loggerhead-instruments/medusa-AI/altium/Medusa-AI-ESP/Project Outputs for Medusa-AI-coral-dev/Medusa-AI-coral-dev-BOM.xlsx

Comment | Description | Designator | Footprint | LibRef | Quantity
0.1uF | Ceramic Chip Capacitor - Standard | C1, C3, C4, C5, C8, C9, C11, C13, C14, C18, C49 | 0402 | C0402 | 11
10uF |  | C2 | Tant0805 | Tant0805 | 1
1uF | Ceramic Chip Capacitor - Standard | C6, C10, C15 | 0402 | C0402 | 3
0.01uF | Ceramic Chip Capacitor - Standard | C7, C12, C16 | 0402 | C0402 | 3
1.0uF | Ceramic Chip Capacitor - Standard | C17, C19, C21, C23, C24, C25, C26, C27, C28, C47 | 0402 | C0402 | 10
100nF | Ceramic Chip Capacitor - Standard | C20, C22 | 0402 | C0402 | 2
10nF | Ceramic Chip Capacitor - Standard | C29, C30 | 0402 | C0402 | 2
1uF |  | C31 | Tant0805 | Tant0805 | 1
0402 Ferrite | Ceramic Chip Capacitor - Standard | C32, C33 | 0402 | C0402 | 2
C0603 | Ceramic Chip Capacitor - Standard, 100V 20% | C34, C37, C38, C42, C48 | 0603 | C0603 | 5
T495X227K010ATE050 | Solid Tantalum Chip Capacitor, Standard T495 Series - Low ESR, Surge Robust | C35, C50 | X | T495X | 2
2.2uF | Ceramic Chip Capacitor - Standard | C36 | 0402 | C0402 | 1
C1206 | Ceramic Chip Capacitor - Standard | C39, C44 | 1206 | C1206 | 2
T495X | Solid Tantalum Chip Capacitor, Standard T495 Series - 35V 10% | C40, C41 | X | T495X | 2
C0805 | Ceramic Chip Capacitor - Standard | C43, C46 | 0805 | C0805 | 2
C0402 | Ceramic Chip Capacitor - Standard | C45 | 0402 | C0402 | 1
PMEG3050EP* |  | D1, D3 | Diode_PMEG3050EP | Diode_PMEG3050EP | 2
26.7V Breakdown |  | D2 | SMBJ24CA | SMBJ24CA | 1
BAT46WJ | Diode Schottky 100V 250mA (DC) Surface Mount SOD-323F | D4 | SOD-323 | BAT46WJ | 1
YFF31HC2A105MT000N | 1ÂµF Feed Through Capacitor 100V 6A 5mOhm 1206 (3216 Metric), 4 PC Pad | FL1, FL2 | FIL_YFF31HC2A105MT000N | YFF31HC2A105MT000N | 2
BM04B-SRSS-TB(LF)(SN) | Connector Header Surface Mount 4 position 0.039 _1.00mm_ | J1, J2 | CONN_BM04B-SRSS-TB(LF)(SN) | BM04B-SRSS-TB(LF)(SN) | 2
6.8uH | Sumida Inductor | L1 | Inductor - duplicate | Inductor 6.8uH | 1
Inductor2016 |  | L2 | Inductor2016 | Inductor2016 | 1
10uH |  | L3 | Inductor0630CDMCD | Inductor_0630CDMCD | 1
MS223-10F | RF Shield | MP1 | MS223-10F | MS223-10F | 1
Header 20X2 | Header, 20-Pin, Dual row | P1 | HDR2X20 | Header 20X2 | 1
microSD-Molex |  | P2 | microSD_Molex_hinged | microSD_Molex_hinged | 1
Teensy3.x |  | P3 | Teensy3.x | Teensy3.x | 1
GND Tie | Header, 2-Pin | P4 | HDR1X2 | Header 2 | 1
HYDROPHONE L | Header, 3-Pin | P5 | HDR1X3 | Header 3 | 1
BAT |  | P6, P33 | HDR_2x1_2mm | HDR_2x1_2mm | 2
HYDROPHONE R | Header, 3-Pin | P7 | HDR1X3 | Header 3 | 1
Iridium | Header, 7-Pin | P8 | HDR1X7 | Header 7 | 1
GPS | Header, 9-Pin | P9 | HDR1X9 | Header 9 | 1
Jumper PPS to Audio R | Header, 2-Pin | P10 | HDR1X2 | Header 2 | 1
Header 3X2 | Header, 3-Pin, Dual row | P11 | HDR2X3 | Header 3X2 | 1
Header 2X2 | Header, 2-Pin, Dual row | P12 | HDR2X2 | Header 2X2 | 1
Header 5X2 | Header, 5-Pin, Dual row | P13 | HDR2X5 | Header 5X2 | 1
Header 4 | Header, 4-Pin | P14 | HDR1X4 | Header 4 | 1
switch | Header, 3-Pin | P15 | HDR1X3 | Header 3 | 1
UltraCap | Header, 2-Pin | P20 | HDR1X2 | Header 2 | 1
3000uF | Header, 3-Pin | P21 | HDR1X3 | Header 3 | 1
SOLAR |  | P24, P25 | HDR_2x1_2mm | HDR_2x1_2mm | 2
100k | Precision Thick Film Chip Resistor, 10 Ohm to 1M Ohm Range, 1% and 0.5% Tolerance, 0603 Size, 0.063 W | R1, R2, R3, R4 | 3-0603 | ERJ3RK | 4
4.7k | Precision Thick Film Chip Resistor, 10 Ohm to 1M Ohm Range, 1% and 0.5% Tolerance, 0603 Size, 0.063 W | R5, R15 | 3-0603 | ERJ3RK | 2
330K | Precision Thick Film Chip Resistor, 10 Ohm to 1M Ohm Range, 1% and 0.5% Tolerance, 0603 Size, 0.063 W | R6, R8, R14 | 3-0603 | ERJ3EK | 3
51K | Precision Thick Film Chip Resistor, 10 Ohm to 1M Ohm Range, 1% and 0.5% Tolerance, 0603 Size, 0.063 W | R7, R9 | 3-0603 | ERJ3EK | 2
301K | Precision Thick Film Chip Resistor, 10 Ohm to 1M Ohm Range, 1% and 0.5% Tolerance, 0603 Size, 0.063 W | R10 | 3-0603 | ERJ3EK | 1
50mOhms | Precision Thick Film Chip Resistor, 10 Ohm to 2.2M Ohm Range, 1% Tolerance, 1206 Size, 0.125 W | R11 | 8-1206 | ERJ8EN | 1
205K | Precision Thick Film Chip Resistor, 10 Ohm to 1M Ohm Range, 1% and 0.5% Tolerance, 0603 Size, 0.063 W | R12 | 3-0603 | ERJ3EK | 1
64K9 | Precision Thick Film Chip Resistor, 10 Ohm to 1M Ohm Range, 1% and 0.5% Tolerance, 0603 Size, 0.063 W | R13 | 3-0603 | ERJ3EK | 1
20k | Precision Thick Film Chip Resistor, 10 Ohm to 1M Ohm Range, 1% and 0.5% Tolerance, 0603 Size, 0.063 W | R16 | 3-0603 | ERJ3RK | 1
MAX4996ETG+ | 3 Circuit IC Switch 2:2 4Ohm 24-TQFN (4x4) | U1 | QFN40P350X350X80-25N | MAX4996ETG+ | 1
LP3985IM5-3.3 | Micropower, 150mA Low-Noise Ultra Low-Dropout CMOS Voltage Regulator | U2, U4, U5, U9, U10 | MF05A_N | LP3985IM5-3.3 | 5
SGTL5000 | SGTL5000 | U3 | QFN32 | SGTL5000 | 1
ADXL343 |  | U6 | ADXL345 | ADXL345 | 1
LIS3MDL | magnetometer | U7 | LGA-12 | LIS3MDL | 1
TLV70018DCKR | Single Output LDO, 200 mA, Fixed 1.8 V Output, 2 to 5.5 V Input, with Low IQ, 5-pin SC70 (DCK), -40 to 125 degC, Green (RoHS & no Sb/Br) | U8 | TI-DCK5_V | TLV70018DCKR | 1
SAM-M8Q |  | U11 | GPS SAM-MQ8 | GPS SAM-M8Q | 1
TPS61032 | Boost converter | U12 | TPS6103x | TPS6103x | 1
LT3652EDDPBF | Power Tracking 2A Battery Charger for Solar Power | U13 | DFN300X300X80-13N | LT3652EDDPBF | 1
M138_MODEM | Swarm M138 Modem | U14 | XCVR_M138_MODEM | M138_MODEM | 1
LD39200PU33R | Linear Voltage Regulator IC 1 Output 2A 6-DFN _3x3_ | U15 | SON95P300X300X100-7N | LD39200PU33R | 1
