loggerhead-instruments/medusa-AI/altium/Swarm-mPCIe-Breakout-Board/Assembly mPCIe_Breakout01/REVA1/BOM/mPCIe_Breakout01.xlsx

Designator | Description | MANUF1 | MANUF1 P/N | Supplier | Supplier P/N | Size | TEMP | Tolerance | Value | 1K COST | Quantity | Footprint | MANUF2 | MANUF2 P/N | Comment
LED4, LED5 | SMD mono-color Chip LED, WL-SMCW, Red | Wurth Electronics | 150060RS75000 | Digikey | 732-4978-2-ND | 0603 | 40 up to +85 °C | NA | RED |  | 2 | 0603_A |  |  | 150060RS75000
J7 | HEADER, 2 Position Wire to Board Terminal Block Horizontal with Board 0.197" (5.00mm) Through Hole | Wurth Electronics Inc. | 691213710002 | Digikey | 732-2038-ND | 5mm | -40°C ~ 105°C | n/a | Green | .68 | 1 | 691213710002 |  |  | 691213710002
J1, J6 | HEADER, 3 Position Wire to Board Terminal Block Horizontal with Board 0.197" (5.00mm) Through Hole | Wurth Electronics Inc. | 691213710003 | Digikey | 732-2039-ND | 5mm | -40°C ~ 105°C | NA | Green | .93 | 2 | 691213710003 |  |  | 691213710003
PAD1, PAD2, PAD3, PAD4 | BUMPER CYLI .375" DIA X .19" BLK |  |  |  |  |  |  |  |  |  | 4 | Bumper |  |  | BS35BL05X10RP
C21 | 4.7 µF ±10% 10V Ceramic Capacitor X7R 0805 (2012 Metric) | Murata | GRM21BR71A475KA73L | Digi-Key | 490-6480-2-ND | 0805 | -55°C ~ 125°C | 10% | 4.7 µF |  | 1 | CAPC2013X135X45LL10T25 |  |  | GRM21BR71A475KA73L
U1 | Dual EIA-232 Driver / Receiver, -40 to 85 degC, 16-Pin SOIC (D), Green (RoHS & no Sb/Br) | Texas Instruments | MAX232IDR | Digi-Key | 296-26141-2-ND | 16SOIC | -40°C ~ 85°C | NA | NA |  | 1 | D0016A_M |  |  | MAX232IDR
L1 | CMC 2A 2LN 1.1 KOHM SMD | Murata Electronics | DLW5ATN112MQ2L | Digikey | 490-12641-2-ND | SMT | -40°C ~ 105°C | NA | 2A | 0.68 | 1 | FIL_DLW5ATN112MQ2L |  |  | DLW5ATN112MQ2L
FL1 | Feed Through Capacitor 100V 5mOhm 1206 (3216 Metric), 4 PC Pad | TDK Corporation | YFF31HC2A105MT000N | Digikey | 445-16151-2-ND | 1206 | -55°C ~ 125°C | 10% | 1uF | 0.19 | 1 | FIL_YFF31HC2A104MT000N_YFF31HC2A104MT000N |  |  | YFF31HC2A105MT000N
F1 | PTC RESET FUSE 24V 2A 2920 | Bel | 0ZCF0200AF2C | Digikey | 507-1749-2-ND | 2920 | -40°C ~ 85°C | NA | 2A |  | 1 | FP-0ZCF0200AF2C-MFG |  |  | 0ZCF0200AF2C
FB1 | Chip Ferrite Bead, 0805, 600Ω @ 100MHz, 0.06Ω, 25%, 2.3A | Murata | BLM21SP601SH1D | Digi-Key | 490-18588-2-ND | 0805 | -55°C ~ 125°C | NA | 600 Ohms @ 100 MHz |  | 1 | FP-BLM21-0_2-t0_85-e0_5-d-IPC_A |  |  | BLM21SP601SH1D
C6, C7, C13, C14, C15, C16 | Cap Ceramic 100nF 50V X7R 10% Pad SMD 0603 +125°C Automotive T/R | TDK | CGA3E2X7R1H104K080AA | Digi-Key | 1276-1033-2-ND | 0603 | -55°C ~ 125°C | 10% | 100nF |  | 6 | FP-CL10-0_1-MFG |  |  | CGA3E2X7R1H104K080AA
C1, C2, C3, C4, C5 | CL21 Series 0805 1uF 50V ±10% Tolerance X7R Multilayer Ceramic Chip Capacitor | Samsung | CL21B105KBFNNNG | Digi-Key | 1276-6470-2-ND | 0805 | -55°C ~ 125°C | 10% | 1 µF |  | 5 | FP-CL21-IPC_C |  |  | CL21B105KBFNNNG
C11 | Chip Multilayer Ceramic Capacitors for General Purpose, 0805, 10uF, X5R, 15%, 10%, 25V | Murata | GRM21BR61E106KA73L | Digi-Key | 490-5523-2-ND | 0805 | -55°C ~ 85°C | 10% | 10 µF |  | 1 | FP-GRM21B-0_15-IPC_C |  |  | GRM21BR61E106KA73L
C19 | Chip Multilayer Ceramic Capacitors for General Purpose, 1206, 4.7uF, X7R, 15%, 10%, 50V | TDK | C3216X5R1H475K | Digi-Key | C3216X5R1H475K | 1206 | 445-5994-2-ND | 10% | 4.7 µF |  | 1 | FP-GRM31C-0_2-e0_3_0_8-IPC_C |  |  | GRM31CR71H475KA12L
C8, C9 | Chip Multilayer Ceramic Capacitors for General Purpose, 1210, 100uF, X5R, 15%, 20%, 10V | Murata | GRM32ER61A107ME20L | Digi-Key | 490-9969-2-ND | 1210 | -55°C ~ 85°C | 20% | 100 µF |  | 2 | FP-GRM32E-0_3-0_2-IPC_B |  |  | GRM32ER61A107ME20L
C17, C18, C20 | Chip Multilayer Ceramic Capacitors for General Purpose, 0805, 10000pF, C0G, 30ppm/°C, 5%, 50V | Murata | GRM2195C1H103JA01D | Digi-Key | 490-1642-2-ND | 0805 | -55°C ~ 125°C | 5% | 10000 pF |  | 3 | FP-GRM219-0_1-IPC_B |  |  | GRM2195C1H103JA01D
U2 | IC TRNSLTR BIDIRECTIONAL 14TSSOP | Texas Instruments | LSF0204DPWR | Digi-Key | 296-40400-2-ND |  | -40°C ~ 125°C | NA | NA |  | 1 | FP-PW0014A-IPC_B |  |  | LSF0204DPWR
J9, J10, J11, J12, J13, J14, J15 | CONN JUMPER SHORTING .100" GOLD | Sullins | QPC02SXGN-RC | Digi-Key | S9337-ND | 2.54MM | -40°C ~ 85°C | NA | 3A |  | 7 | FP-QPC02SXGN-RC-MFG |  |  | QPC02SXGN-RC
D3 | TVS DIODE 15V 24.4V SMA | Diodes | SMAJ15A-13-F | Digikey | SMAJ15A-FDITR-ND | SMA | -50°C ~ 150°C | NA | NA |  | 1 | FP-SMA-MFG |  |  | SMAJ15A-13-F
J2, J4 | CONN U.FL RCPT STR 50 OHM SMD | Hirose | U.FL-R-SMT(10) | Digikey | H9161TR-ND | SMT | -40°C ~ 90°C | NA | NA |  | 2 | FP-U_FL-R-SMT_10-MFG |  |  | U.FL-R-SMT(10)
J8 | CONN RCPT USB2.0 TYPEC 5A | Global Connector Technology | USB4105-GF-A | Digikey | 2073-USB4105-GF-ATR-ND | SMT/TH | -40°C ~ 85°C | NA | NA |  | 1 | FP-USB4105-GF-A-MFG |  |  | USB4105-GF-A
D1 | Zener Voltage Regulator, 225 mW, 3-Pin SOT-23, Pb-Free, Tape and Reel | ON Semiconductor | BZX84B5V1LT1G | Digi-Key | BZX84B5V1LT1GOSTR-ND | SOT-23 | -65°C ~ 150°C | NA | 225 mW |  | 1 | ONSC-SOT-23-3-318-08_V |  |  | BZX84B5V1LT1G
U5 | USB Bridge, USB to UART USB 2.0 UART Interface 28-QFN (5x5) | Silicon Labs | CP2102N-A02-GQFN28 | Digi-Key | 336-5890-2-ND | QFN-28 | -40°C ~ 85°C | N/A | N/A | 1.22 | 1 | QFN50P500X500X100_HS-29N |  |  | CP2102N-A02-GQFN28
R19 | RES SMD 25.5KOHM 0.1% 1/10W 0603 | Susumu | RG1608P-2552-B-T5 | Digi-Key | RG16P25.5KBTR-ND | 0603 | -55°C ~ 125°C | 0.1% | 25.5 kOhms |  | 1 | RESC1608X50X30LL20T20 |  |  | RG1608P-2552-B-T5
R2, R3 | RES SMD 1.2K OHM 5% 1/10W 0603 | Bourns | CR0603-JW-122ELF | Digikey | 118-CR0603-JW-122ELFTR-ND | 0603 | -55°C ~ 155°C | ±5% | 1K2 |  | 2 | RESC1608X55X30LL15T15 |  |  | ERJ-3GEYJ122V
R7, R11, R12, R14, R17, R20 | RES SMD 1K OHM 0.1% 1/10W 0603, RES SMD 7.5K OHM 0.1% 1/10W 0603 | Panasonic | ERA-3AEB102V, ERA-3AEB752V | Digi-Key | P1.0KDBTR-ND, P7.5KDBTR-ND | 0603 | -55°C ~ 155°C | ±0.1% | 1K, 7K5 |  | 6 | RESC1608X55X30LL20T20 |  |  | ERA3AEB102V
R4, R5, R6, R9, R13, R15 | RES SMD 2.2K OHM 5% 1/10W 0603 | Vishay | CRCW06032K20JNEA | Digi-Key | 541-2.2KGTR-ND | 0603 | -55°C ~ 155°C | ±5% | 2k2 |  | 6 | RESC1609X50X30LL10T20 |  |  | CRCW06032K20JNEA
R16, R18 | RES SMD 5.1K OHM 1% 1/8W 0805 | Panasonic | ERJ-6ENF5101V | Digi-Key | P5.10KCTR-ND | 0603 | -55°C ~ 155°C | ±1% | 5K1 |  | 2 | RESC2013X70X40LL20T20 |  |  | ERJ6ENF5101V
U3 | SWARM M138 MODEM mPCIe 2.005" (50.925mm) x 1.18" (30mm) Two part connector | JAE | A: MM60-52B1-B1-R850 B: MM60-EZH039-B5-R850 | Digikey | A: 670-2274-2-ND B: 670-2276-2-ND | mPCIe | -40°C ~ 85°C | NA | NA |  | 1 | RF_VHF_JAE_MM60-52B1-B1-R850_MM60-EZH039-B5-R850_w_2005_mPCIe_card |  |  | A: MM60-52B1-B1-R850 B: MM60-EZH039-B5-R850
U4 | USB ESD PROTECTION | STMicroelectronics | USBLC6-4SC6 | Digi-Key | 497-4492-2-ND | SOT-23-6 | -40°C ~ 125°C | N/A | N/A | 0.17903 | 1 | SM/SOT23-6PIN |  |  | USBLC6-4SC6
J16, J17, J18, J19, J20, J22, J23 | Male Header, Pitch 2.54 mm, 1 x 2 Position, Height 8.38 mm, Tail Length 2.54 mm, -55 to 125 degC, RoHS, Bulk | Samtec | TSW-102-07-S-S | Digi-Key | SAM1033-02-ND | TH | -55°C ~ 125°C | NA | NA |  | 7 | SMTC-TSW-102-07-S-S |  |  | TSW-102-07-S-S
J21 | 0.025" SQ Post Header, Through-hole, Vertical, -55 to 125 degC, 2.54 mm Pitch, 3-Pin, Male, RoHS | Samtec | TSW-103-07-L-S | Digi-Key | SAM1031-03-ND | TH | -55°C ~ 125°C | NA | NA |  | 1 | SMTC-TSW-103-07-X-S |  |  | TSW-103-07-L-S
FTDI | 0.025" SQ Post Header, Through-hole, Vertical, -55 to 125 degC, 2.54 mm Pitch, 6-Pin, Male, RoHS | Samtec | TSW-106-07-F-S | Digi-Key | SAM10852-ND | TH | -55°C ~ 125°C | NA | NA |  | 1 | SMTC-TSW-106-07-X-S |  |  | TSW-106-07-F-S
D2, D4 | DIODE SCHOTTKY 30V 5A SOD128 | NXP Semiconductors | PMEG3050EP,115 | Digikey | 1727-5317-1-ND | SOD-128 | -55°C ~ 175°C | NA | 5A | .28 | 2 | SODFL620X110-2N |  |  | PMEG3050EP,115
J3, J5 | Rf Coax Conn, Sma Jack, 50 Ohm, Pcb Rohs Compliant: Yes |  |  | Digikey | 17-5-1814832-2CT-ND |  | -65°C ~ 165°C |  |  |  | 2 | TECO-5-1814832-1_V |  |  | CMP-2000-05705-2
U6 | 2A Standard Variable Output LDO Regulator | Rohm | BD00D0AWHFP-TR | Digi-Key | BD00D0AWHFPTR-ND | HRP-5 | -40°C ~ 105°C | NA | 0.55V @ 1A |  | 1 | TO172P1054X2005-6N |  |  | BD00D0AWHFP-TR
LED1, LED3 | WL-SMCW SMD Chip LED Top View Monocolor Waterclear, 30 mA, 2 V, -40 to 85 degC, 2-Pin SMD, RoHS, Tape and Reel GRN | Wurth Electronics | 150060VS75000 | Digi-Key | 732-4980-2-ND | 0603 | 40 up to +85 °C | NA | GRN |  | 2 | WE-150060VS75000_V |  |  | 150060VS75000
