loggerhead-instruments/medusa-AI/altium/Antenna/Swarm-Medusa-Antenna/Swarm-Medusa-Antenna.step

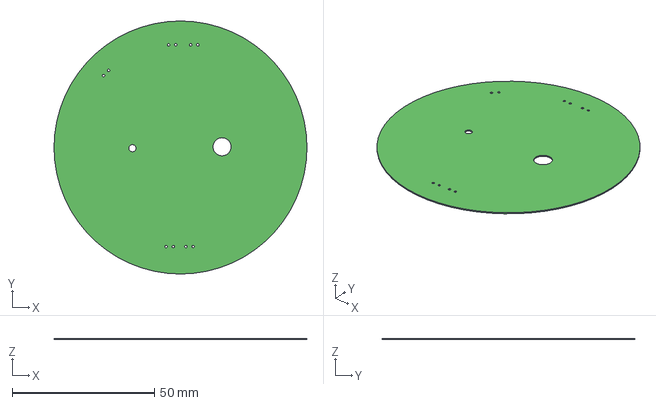
[picture p10: CAD file, 2021-11-11]
altium/Antenna/Swarm-Medusa-Antenna/Swarm-Medusa-Antenna.step
88.9 x 88.9 x 0.411 mm
