loggerhead-instruments/medusa-AI/altium/Medusa-AI-ESP/ZX-0808K-01.STEP

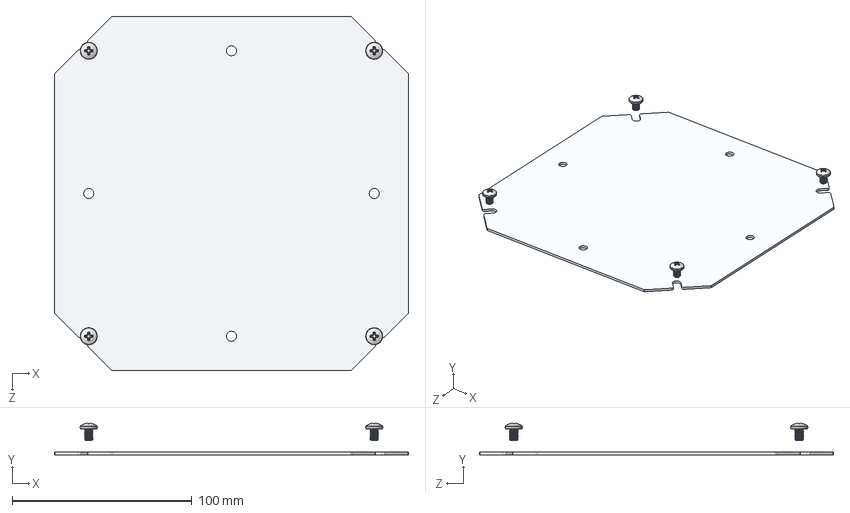
[picture p11: CAD file, 2022-02-02]
altium/Medusa-AI-ESP/ZX-0808K-01.STEP
196.9 x 17.6 x 196.8 mm
ZX-0808P-01
SCREWS-011_SCREWS-011 x 4
