loggerhead-instruments/medusa-AI/altium/medusa-AI.step

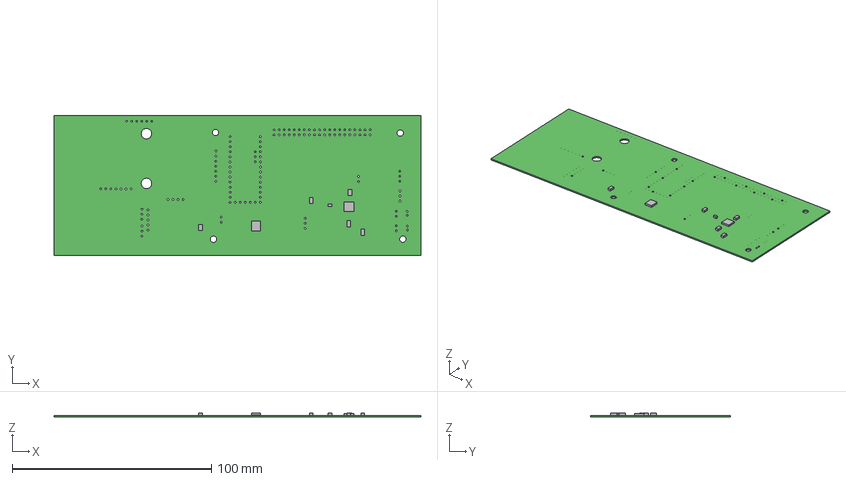
[picture p12: CAD file, 2021-11-11]
altium/medusa-AI.step
184.4 x 70.2 x 2.00 mm
Extruded x 8
