loggerhead-instruments/medusa-AI/solarTests/SunnyBuddyTestWithLS1_4LiPo.CSV

filename | ID | gain (dB) | Voltage | Version
20201031T094200.wav | 04233229012120210 | 6.56 | 3.74 | 2019-04-12
20201031T094330.wav | 04233229012120210 | 6.56 | 3.78 | 2019-04-12
20201031T094500.wav | 04233229012120210 | 6.56 | 3.78 | 2019-04-12
20201031T094630.wav | 04233229012120210 | 6.56 | 3.79 | 2019-04-12
20201031T094800.wav | 04233229012120210 | 6.56 | 3.81 | 2019-04-12
20201031T094930.wav | 04233229012120210 | 6.56 | 3.80 | 2019-04-12
20201031T095100.wav | 04233229012120210 | 6.56 | 3.79 | 2019-04-12
20201031T095230.wav | 04233229012120210 | 6.56 | 3.81 | 2019-04-12
20201031T095400.wav | 04233229012120210 | 6.56 | 3.73 | 2019-04-12
20201031T095530.wav | 04233229012120210 | 6.56 | 3.76 | 2019-04-12
20201031T095700.wav | 04233229012120210 | 6.56 | 3.84 | 2019-04-12
20201031T095830.wav | 04233229012120210 | 6.56 | 3.80 | 2019-04-12
20201031T100000.wav | 04233229012120210 | 6.56 | 3.83 | 2019-04-12
20201031T100130.wav | 04233229012120210 | 6.56 | 3.76 | 2019-04-12
20201031T100300.wav | 04233229012120210 | 6.56 | 3.81 | 2019-04-12
20201031T100430.wav | 04233229012120210 | 6.56 | 3.74 | 2019-04-12
20201031T100600.wav | 04233229012120210 | 6.56 | 3.78 | 2019-04-12
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
