loggerhead-instruments/medusa-AI/(list of files, drawings)

Other design files:
altium/Antenna/Swarm-Medusa-Antenna/Swarm-Medusa-Antenna.PcbDoc
altium/Antenna/Swarm-Medusa-Antenna/Swarm-Medusa-Antenna.PrjPcb
altium/Antenna/Swarm-Medusa-Antenna/Swarm-Medusa-Antenna.SchDoc
altium/ESP-audio-breakout/ESP-audio-breakout.PcbDoc
altium/ESP-audio-breakout/ESP-audio-breakout.PrjPcb
altium/ESP-audio-breakout/ESP-audio-breakout.SchDoc
altium/ESP-audio-breakout/medusa-ai-audio.SchDoc
altium/ESP-PCM1822Q1-breakout/ESP-PCM1822Q1-breakout.PcbDoc
altium/ESP-PCM1822Q1-breakout/ESP-PCM1822Q1-breakout.PrjPcb
altium/ESP-PCM1822Q1-breakout/ESP-PCM1822Q1-breakout.SchDoc
altium/ESP-PCM1822Q1-breakout/medusa-ai-audio.SchDoc
altium/medusa-AI-audio.SchDoc
altium/Medusa-AI-battery/Medusa-AI-battery.PcbDoc
altium/Medusa-AI-battery/Medusa-AI-battery.PrjPcb
altium/Medusa-AI-battery/Medusa-AI-battery.SchDoc
altium/Medusa-AI-coral-dev/Medusa-AI-coral-dev.PcbDoc
altium/Medusa-AI-coral-dev/Medusa-AI-coral-dev.PrjPcb
altium/Medusa-AI-coral-dev/Medusa-AI-coral-dev.SchDoc
altium/Medusa-AI-ESP/medusa-ai-audio.SchDoc
altium/Medusa-AI-ESP/Medusa-AI-ESP.PcbDoc
altium/Medusa-AI-ESP/Medusa-AI-ESP.PrjPcb
altium/Medusa-AI-ESP/Medusa-AI-ESP.SchDoc
altium/Medusa-AI-ESP/medusa-ai-power.SchDoc
altium/Medusa-AI-ESP/medusa-ai-sensors.SchDoc
altium/Medusa-AI-ESP/medusa-charger.SchDoc
altium/Medusa-AI-integrated-charger/Medusa-AI-integrated-charger.PrjPcb
altium/Medusa-AI-integrated-charger/medusa-ai-integrated-charger.SchDoc
altium/Medusa-AI-integrated-charger/medusa-ai-integrated.PcbDoc
altium/medusa-AI-power.SchDoc
altium/medusa-AI-sensors.SchDoc
altium/medusa-AI.PcbDoc
altium/medusa-AI.PrjPCB
altium/medusa-AI.SchDoc
altium/medusaCharger/medusaCharger.PcbDoc
altium/medusaCharger/medusaCharger.PrjPcb
altium/medusaCharger/medusaCharger.SchDoc
altium/microSDAdaptor/microSDAdaptor.PcbDoc
altium/microSDAdaptor/microSDAdaptor.PrjPcb
altium/microSDAdaptor/microSDAdaptor.SchDoc
altium/PCB_Project/PCB_Project.PrjPcb
altium/Swarm-M138-Modem-Altium-Footprint/Altium Footprint/SWARM_M138.PcbLib
altium/Swarm-M138-Modem-Altium-Footprint/Altium Footprint/SWARM_M138.SCHLIB
altium/Swarm-mPCIe-Breakout-Board/Sources/mPCIe_Breakout01.PrjPCB
altium/Swarm-mPCIe-Breakout-Board/Sources/PCB/mPCIe_Breakout01_2X2_PNL.PcbDoc
altium/Swarm-mPCIe-Breakout-Board/Sources/SCH/mPCIe_Breakout01-SCH-PAGE2_MAIN.SchDoc
altium/Swarm-mPCIe-Breakout-Board/Sources/SCH/mPCIe_Breakout01_SCH-PAGE1_TITLE.SchDoc
altium/Swarm-mPCIe-Breakout-Board/Sources/SCH/mPCIe_Breakout01_SCH-PAGE3_POWER_SUPPLY.SchDoc
altium/Tile-carrier/Tile-carrier.PcbDoc
altium/Tile-carrier/Tile-carrier.PrjPcb
altium/Tile-carrier/Tile-carrier.SchDoc
devBoardMini/Medusa-AI-coral-dev.PrjPcb
