loggerhead-instruments/medusa-AI/arduino/medusa-AI/display.ino

/* DISPLAY FUNCTIONS
 *  
 */

void displayOn(){
  display.begin(SSD1306_SWITCHCAPVCC, 0x3C);  //initialize display
}

void displayOff(){
  display.ssd1306_command(SSD1306_DISPLAYOFF);
}

void cDisplay(){
  display.clearDisplay();
  display.setTextColor(WHITE);
  display.setTextSize(1);
  display.setCursor(65,0);
  #ifdef IRIDIUM_MODEM
    display.print("I:");
    display.print(sigStrength);
  #endif
  
  display.setCursor(90,0);
  display.print(voltage,1);
  display.print("V");

  #ifdef SWARM_MODEM
    display.setCursor(90,9);
    display.print(rssi);
  #endif
  
  display.setCursor(0,0);
  display.display();
}

void displaySettings(){
  display.setTextSize(1);
  display.setTextColor(WHITE);
  display.setCursor(0, 0);
  if(mode==0) {
    display.println("SBY");
    display.print(startTime - t);
    display.println("s");
  }
  display.print("Rec ");
  display.print(rec_dur);
  display.print("s");
  display.print("  Sleep ");
  display.print(rec_int);
  display.println("s");
}

void displayClock(int loc, time_t t){
  display.setTextSize(1);
  display.setCursor(0,loc);
  display.print(year(t));
  display.print('-');
  display.print(month(t));
  display.print('-');
  display.print(day(t));
  display.print("  ");
  printZero(hour(t));
  display.print(hour(t));
  printDigits(minute(t));
  printDigits(second(t));
}

void printDigits(int digits){
  // utility function for digital clock display: prints preceding colon and leading 0
  display.print(":");
  printZero(digits);
  display.print(digits);
}

void printZero(int val){
  if(val<10) display.print("0");
}


// 
//void printDigits(int digits){
//  // utility function for digital clock display: prints preceding colon and leading 0
//  display.print(":");
//  printZero(digits);
//  display.print(digits);
//}
//
//void printZero(int val){
//  if(val<10) display.print('0');
//}

void setTeensyTime(int hr, int mn, int sc, int dy, int mh, int yr){
  tmElements_t tm;
  tm.Year = yr - 1970;
  tm.Month = mh;
  tm.Day = dy;
  tm.Hour = hr;
  tm.Minute = mn;
  tm.Second = sc;
  time_t newtime;
  newtime = makeTime(tm); 
  Teensy3Clock.set(newtime); 
}
 
void printTime(time_t t){
  Serial.print(year(t));
  Serial.print('-');
  Serial.print(month(t));
  Serial.print('-');
  Serial.print(day(t));
  Serial.print(" ");
  Serial.print(hour(t));
  Serial.print(':');
  Serial.print(minute(t));
  Serial.print(':');
  Serial.println(second(t));
}

void readEEPROM(){
  rec_dur = readEEPROMlong(0);
  rec_int = readEEPROMlong(4);
}

union {
  byte b[4];
  long lval;
}u;

long readEEPROMlong(int address){
  u.b[0] = EEPROM.read(address);
  u.b[1] = EEPROM.read(address + 1);
  u.b[2] = EEPROM.read(address + 2);
  u.b[3] = EEPROM.read(address + 3);
  return u.lval;
}

void writeEEPROMlong(int address, long val){
  u.lval = val;
  EEPROM.write(address, u.b[0]);
  EEPROM.write(address + 1, u.b[1]);
  EEPROM.write(address + 2, u.b[2]);
  EEPROM.write(address + 3, u.b[3]);
}

void writeEEPROM(){
  writeEEPROMlong(0, rec_dur);  //long
  writeEEPROMlong(4, rec_int);  //long
}
