loggerhead-instruments/medusa-AI/(commit log)

2020-10-20 initial schematic
    [medusa-AI-audio.SchDoc, medusa-AI-sensors.SchDoc, medusa-AI.PrjPCB, medusa-AI.SchDoc]
2021-01-18 add iridium antenna IR
    [medusa-AI-sensors.SchDoc, medusa-AI.PcbDoc, medusa-AI.SchDoc]
2021-01-19 FInal PCB
    [medusa-AI-sensors.SchDoc, medusa-AI.PcbDoc, medusa-AI.PrjPCB, medusa-AI.SchDoc]
2021-02-11 logic for SD switch
2021-02-13 pick and place
    [Pick Place for medusa-AI.csv, Pick Place for medusa-AI.xlsx, medusa-AI.PcbDoc, medusa-AI.PrjPCB]
2021-02-13 Pi control by Teensy
2021-02-13 pi no 3v3 connection
    [medusa-AI.PcbDoc, medusa-AI.SchDoc]
2021-02-14 remove 3v3 from pi
    [medusa-AI.PcbDoc]
2021-03-03 Swarm antenna PCB
    [Swarm-Medusa-Antenna.PcbDoc, Swarm-Medusa-Antenna.PrjPcb, Swarm-Medusa-Antenna.SchDoc]
2021-03-03 rearrange Medusa PCB
    [medusa-AI-sensors.SchDoc, medusa-AI.PcbDoc, medusa-AI.SchDoc]
2021-03-03 Increase record duration for power test
2021-03-08 antenna board
2021-03-16 parse DT and GPS
    [medusa-AI.PrjPCB]
2021-03-16 println for data packet
2021-04-05 solar panels parallel ground plane
    [Swarm-Medusa-Antenna.PcbDoc, Swarm-Medusa-Antenna.SchDoc]
2021-04-05 Tile carrier PCB
    [Tile-carrier.PcbDoc, Tile-carrier.PrjPcb, Tile-carrier.SchDoc]
2021-04-05 add diodes and via stitching
    [Swarm-Medusa-Antenna.PcbDoc, Swarm-Medusa-Antenna.SchDoc]
2021-04-05 update tile carrier
    [Tile-carrier.PcbDoc]
2021-04-06 Add tile
    [medusa-AI-power.SchDoc, medusa-AI.PcbDoc, medusa-AI.PrjPCB, medusa-AI.SchDoc]
2021-04-26 update PCB
    [Pick Place for medusa-AI.csv, Swarm-Medusa-Antenna.PrjPcb]
2021-09-30 solar charger pcb
    [medusaCharger.PrjPcb, medusaCharger.SchDoc]
2021-10-12 via stitching
    [medusaCharger.PcbDoc, medusaCharger.PrjPcb]
2021-11-16 bugfix dirs, logging try/except
    [audioProcess.py]
2021-12-01 sleep if battery low & log RSSI
2021-12-01 update voltage reading prior to start
2021-12-03 revert to Iridium and external GPS
    [display.ino, medusa-AI.ino]
2021-12-09 iridium powered off battery
2021-12-09 altium update
    [medusa-AI.PrjPCB, medusa-AI.SchDoc]
2022-02-02 Medusa-AI Integrated PCB
    [Medusa-AI-integrated-charger.PrjPcb, ZX-0808K-01.STEP, medusa-ai-audio.SchDoc, medusa-ai-integrated-charger.SchDoc, medusa-ai-integrated.PcbDoc, medusa-ai-power.SchDoc, medusa-charger.SchDoc]
2022-02-02 Don't send when voltage <3.7V
2022-02-02 update project structure
    [Medusa-AI-integrated-charger.PrjPcb, medusa-ai-integrated.PcbDoc]
2022-02-02 sensors on separate schematic; add GPS
    [medusa-ai-audio.SchDoc, medusa-ai-integrated-charger.SchDoc, medusa-ai-integrated.PcbDoc, medusa-ai-sensors.SchDoc, medusa-charger.SchDoc]
2022-02-04 Battery PCB
    [Medusa-AI-battery.PcbDoc, Medusa-AI-battery.PrjPcb, Medusa-AI-battery.SchDoc]
2022-02-04 remove battery connectors
    [medusa-ai-integrated.PcbDoc, medusa-charger.SchDoc]
2022-02-09 initial integrated Medusa-AI layout
    [Medusa-AI-battery.PcbDoc, Medusa-AI-integrated-charger.PrjPcb, medusa-ai-audio.SchDoc, medusa-ai-integrated-charger.SchDoc, medusa-ai-integrated.PcbDoc, medusa-ai-power.SchDoc, medusa-charger.SchDoc]
2022-02-10 adafruit GPS footprint, fix display footprint, Pi mounting holes
    [medusa-ai-integrated-charger.SchDoc, medusa-ai-integrated.PcbDoc, medusa-ai-sensors.SchDoc]
2022-02-10 logo and contact info
    [medusa-ai-integrated.PcbDoc]
2022-02-10 second optional mounting location for Coral
    [medusa-ai-integrated.PcbDoc]
2022-02-12 rockblock Vin
    Pi and Iridium run off VCC5. When VCC5 turned on, Iridium should be put to sleep so doesn't draw power.
    [medusa-ai-integrated-charger.SchDoc, medusa-ai-integrated.PcbDoc, medusa-ai-power.SchDoc]
2022-02-14 medusa-ai battery project update
    [Medusa-AI-battery.PrjPcb]
2022-02-14 medusa-AI project update
    [Medusa-AI-integrated-charger.PrjPcb]
2022-03-09 move cap and resistors to avoid collision and being covered
    [medusa-ai-integrated.PcbDoc]
2022-03-09 Update Pick Place for medusa-ai-integrated.xlsx
    [Pick Place for medusa-ai-integrated.xlsx]
2022-04-19 coral dev board mini
    [Medusa-AI-coral-dev.PrjPcb, Medusa-AI-coral-dev.SchDoc, Pick Place for medusa-ai-integrated.csv, Pick Place for medusa-ai-integrated.xlsx, ZX-0808K-01.STEP, medusa-ai-audio.SchDoc, medusa-ai-power.SchDoc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]
2022-04-19 add swarm
    [Medusa-AI-coral-dev.SchDoc, medusa-ai-power.SchDoc, medusa-charger.SchDoc]
2022-04-20 fix Swarm RX/TX
    [Medusa-AI-coral-dev.PcbDoc, Medusa-AI-coral-dev.PrjPcb, Medusa-AI-coral-dev.SchDoc]
2022-04-20 move coral away from edge; DRC
    [Medusa-AI-coral-dev.PcbDoc, Medusa-AI-coral-dev.SchDoc]
2022-04-21 move dev board mini; add big cap to swarm
    [Medusa-AI-coral-dev.PcbDoc, medusa-ai-power.SchDoc]
2022-05-27 microSD adaptor
    [microSDAdaptor.PcbDoc, microSDAdaptor.PrjPcb, microSDAdaptor.SchDoc]
2022-06-16 update with larger solar charger chip
    [Medusa-AI-coral-dev.PcbDoc, Medusa-AI-coral-dev.SchDoc, medusa-charger.SchDoc]
2022-06-23 medusa ai update
    [Medusa-AI-coral-dev-BOM.xlsx, Medusa-AI-coral-dev.PcbDoc]
2022-07-15 move power connector header for Coral
    [Medusa-AI-coral-dev.PcbDoc]
2022-08-25 add header to wire Coral button to Teensy pin
    [Medusa-AI-coral-dev.PcbDoc, Medusa-AI-coral-dev.SchDoc, medusa-charger.SchDoc]
2022-08-26 fix solar charger circuit
    [Medusa-AI-coral-dev.PcbDoc, Medusa-AI-coral-dev.SchDoc, medusa-ai-audio.SchDoc, medusa-charger.SchDoc]
2022-09-06 stop switch
    [Medusa-AI-coral-dev.PcbDoc, Medusa-AI-coral-dev.SchDoc, Pick Place for medusaCharger.csv, medusa-ai-sensors.SchDoc, medusa-charger.SchDoc]
2022-12-07 PPS GPS module
    [Medusa-AI-coral-dev.PrjPcb, medusa-ai-audio.SchDoc, medusa-ai-power.SchDoc]
2023-03-29 medusa AI ESP
    [Medusa-AI-ESP.PcbDoc, Medusa-AI-ESP.PrjPcb, Medusa-AI-ESP.SchDoc, Medusa-AI-coral-dev-BOM.xlsx, Pick Place for Medusa-AI-coral-dev.csv, ZX-0808K-01.STEP, medusa-ai-audio.SchDoc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]
2023-04-26 ESP ES7210 audio breakout
    [ESP-audio-breakout.PcbDoc, ESP-audio-breakout.PrjPcb, ESP-audio-breakout.SchDoc, Medusa-AI-ESP.PcbDoc, Medusa-AI-ESP.SchDoc, Pick Place for Medusa-AI-ESP.csv, medusa-ai-audio.SchDoc, medusa-ai-sensors.SchDoc]
2023-04-26 add mounting holes
    [ESP-audio-breakout.PcbDoc]
2023-04-26 move fiducials
    [ESP-audio-breakout.PcbDoc]
2023-04-26 move mounting holes
    [ESP-audio-breakout.PcbDoc]
2023-05-17 ESP-PCM1822 PCB Routed
    [ESP-PCM1822Q1-breakout.PcbDoc, ESP-PCM1822Q1-breakout.PrjPcb, ESP-PCM1822Q1-breakout.SchDoc, ESP-audio-breakout.PcbDoc, ESP-audio-breakout.PrjPcb, Pick Place for ESP-audio-breakout.csv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]
2023-06-15 large board
    [ESP-PCM1822Q1-breakout.PcbDoc, ESP-PCM1822Q1-breakout.SchDoc, Pick Place for ESP-PCM1822Q1-breakout.csv, medusa-ai-audio.SchDoc]
2024-12-05 Medisa+9x8 schematic partial PCB
    [Medusa_9x8.PcbDoc, Medusa_9x8.PrjPcb, Medusa_9x8.SchDoc, Medusa_9x8_audio.SchDoc, Pick Place for ESP-PCM1822Q1-breakout.csv]
2024-12-05 parts on PCB
    [Medusa_9x8.PcbDoc, Medusa_9x8.SchDoc]
2024-12-11 clean up
    [Medusa_9x8.PcbDoc, Medusa_9x8.PrjPcb, Medusa_9x8.SchDoc, Medusa_9x8_audio.SchDoc]
